adam-ctrlc/vital/README.md

# Vital

A Transformer Alert Management System for a 1 KVA distribution transformer, built as an electrical engineering thesis project at PHINMA Cagayan de Oro College, Carmen Campus.

An ESP32 measures the transformer and reports it to a Go API, which stores every sample, raises alerts when a reading crosses a threshold, and serves live readings to a web app that also ships as an Android app through Capacitor. The board also protects the transformer itself, opening a relay when the load runs away. The API can simulate the transformer from the clock, so the whole system can be demonstrated end to end with or without the hardware wired in.

## What it does

- Live monitoring of voltage, current, temperature and apparent power, with an animated AC waveform
- **Two-stage load protection**: an alarm at **900 VA** raises an alert, and a trip at **980 VA** opens the relay. Temperature alarms at **40 °C** but does not trip
- Alerts carry acknowledgement and response time, and the reading that triggered them, so a card shows how the transformer reached the threshold rather than only the value that crossed it
- Push notifications with a choice of **30 bundled tones**, a vibration pattern, and an alert length up to ten minutes. Everything is per device and can be switched off entirely
- Historical logs with server-side search, source and status filtering, and pagination, plus a daily load trend
- A data-source switch between a live ESP32 (the default) and the built-in simulation; hardware readings only show while the board is reporting, otherwise the dashboard reads "No data"
- Real device telemetry (IP, signal, uptime, firmware) reported by the board itself
- Configurable thresholds and full account management
- Two roles, decided by the account rather than a picker at sign-in

| Role | Who | Can reach |
|---|---|---|
| `admin` | Maintenance engineers | Everything: dashboard, alerts, logs, settings, users |
| `user` | Power utility personnel | Dashboard and alerts only |

## Architecture

```
ESP32  ──POST /readings + /device/heartbeat──>  Go API  ──>  Turso (libSQL)
   (x-device-key)                                  │
Web app   ──polls, bearer token───────────────────┘
(browser or Android, via Capacitor)
```

The API is stateless. Serverless functions cannot keep a background loop alive, so in simulation mode readings are a pure function of the clock, and a sample is persisted only when the newest stored row is older than `SAMPLE_INTERVAL_MS`. In hardware mode the ESP32 pushes readings and the API serves the latest one while it stays fresh.

## Tech stack

**API** Go, net/http, database/sql with libsql-client-go against Turso (SQLite over HTTP), JWT (HS256) auth, argon2id password hashing. Deployed to Vercel in the `hnd1` region, which is where the database is: every query is an HTTP request, so the two being in different countries cost about seventy milliseconds each way, every time.

**App** Vite, React 19, TypeScript, React Router, Tailwind, Phosphor icons and KaTeX, packaged for Android with Capacitor 8. It is a 1:1 port of the original Expo app, which has been retired.

**Firmware** ESP32 reading a PZEM-004T v3 energy meter and a DS18B20 contact temperature probe, tripping a relay, and driving a 20x4 I2C LCD. Header-only C++ with one class per component, ArduinoJson for every payload it builds or reads.

## Project structure

```
api/            Go API (see api/README.md)
  internal/     one package per domain: account, auth, readings, alerts, settings, device, users
  cmd/          server (local) and migrate
  schema.sql    the whole schema, applied by `go run ./cmd/migrate`
  migrations/   one-off changes to the existing database
  scripts/      pg-to-turso.mjs and other one-off data copies
  api/index.go  Vercel serverless entrypoint
appv2/          web app, and the Android app through Capacitor (see appv2/README.md)
  src/routes/   screens; tabs/ holds the tab group
  src/features/ API clients and types, split by domain
  src/components/
  android/      the Capacitor Android project
esp32/          firmware (see esp32/structure.txt and esp32/pins.txt)
  esp32.ino     mode selector: REAL_MODE, plus DS18B20 / LCD / PZEM / backend tests
  src/          config, hardware, net, core, tests (header-only classes)
```

## Getting started

### API

Create `api/.env`:

```
DATABASE_URL=libsql://your-database.turso.io   # https:// is accepted too
DATABASE_AUTH_TOKEN=the-token-turso-issues
JWT_SECRET=a-long-random-string
DEVICE_API_KEY=a-long-random-string
PORT=8080

# Read by the seeder only, never by the server.
SEED_ADMIN_PASSWORD=...
SEED_USER_PASSWORD=...
```

```bash
cd api
go run ./cmd/server
```

Apply the schema once with `go run ./cmd/migrate`. The server never does it: on serverless that would replay every statement on each cold start to discover there is nothing to do, and a schema change is a decision somebody makes rather than something that happens because a request arrived. Every statement is `if not exists`, so running it again is safe.

### Accounts

There are no accounts until you create one, and **the seeder is not committed**: this repository is public, and the accounts it creates are the live ones, since development and production share a database. Create `api/cmd/seed/main.go` (ignored by git):

```go
package main

import (
	"context"
	"log"
	"os"

	"github.com/google/uuid"

	"github.com/adam-ctrlc/vital/api/internal/auth"
	"github.com/adam-ctrlc/vital/api/internal/config"
	"github.com/adam-ctrlc/vital/api/internal/db"
)

func main() {
	if _, err := config.LoadDotenv(".env"); err != nil {
		log.Fatal(err)
	}
	cfg, err := config.Load()
	if err != nil {
		log.Fatal(err)
	}

	// From the environment, never a literal. The insert below reapplies the password
	// on every run, so a password written here would silently undo any rotation.
	plain := os.Getenv("SEED_ADMIN_PASSWORD")
	if plain == "" {
		log.Fatal("SEED_ADMIN_PASSWORD is not set")
	}
	hash, err := auth.HashPassword(plain)
	if err != nil {
		log.Fatal(err)
	}

	conn, err := db.Open(cfg.DatabaseURL, cfg.DatabaseToken)
	if err != nil {
		log.Fatal(err)
	}
	defer conn.Close()

	// The id is generated here because SQLite has no gen_random_uuid().
	_, err = conn.ExecContext(context.Background(),
		`insert into users (id, email, username, password_hash, role, first_name, last_name)
		 values (?, ?, ?, ?, ?, ?, ?)
		 on conflict (email) do update set password_hash = excluded.password_hash`,
		uuid.NewString(), "you@example.com", "you", hash, "admin", "Your", "Name")
	if err != nil {
		log.Fatal(err)
	}
}
```

```bash
go run ./cmd/seed
```

Further accounts can be created and edited from the app by an admin. Sign in with an email or a username.

### App

Create `appv2/.env`:

```
VITE_API_URL=http://localhost:8080/api/v1
```

```bash
cd appv2
pnpm install
pnpm dev
```

The site runs at http://localhost:5173. For the Android app, `pnpm apk` builds the site, syncs it into `android/` and assembles a debug APK; it needs JDK 21 and the Android SDK. The API URL is baked in at build time, and a phone cannot reach `localhost`, so build the APK against your machine's LAN address or a deployed API.

### Firmware

Copy `esp32/secrets.example.h` to `esp32/secrets.h` (gitignored) and fill in `WIFI_SSID`, `WIFI_PASSWORD`, `BACKEND_URL` and `DEVICE_KEY` (the key must match the API's `DEVICE_API_KEY`). Install the libraries listed in `esp32/structure.txt` (hd44780, OneWire, DallasTemperature, PZEM004Tv30, and **ArduinoJson 7 or newer**), pick a mode at the top of `esp32.ino`, and flash. `esp32/pins.txt` documents the wiring.

Flash `TEST_MODE = TEST_LCD` first. Its ruler screen fills all four rows to twenty columns, so a blank row or column means the configured geometry does not match the panel.

## API

Everything is under `/api/v1`. All routes except `/health` and `/auth/login` need a bearer token, except the ingest and device endpoints, which authenticate with the `x-device-key` header.

| Route | Method | Access | Notes |
|---|---|---|---|
| `/health` | GET | public | Check time, UTC and local |
| `/auth/login` | POST | public | Email or username; returns a token and the account. Rate limited per caller |
| `/auth/me` | GET / PUT | any | Read or update the current account |
| `/auth/password` | PUT | any | Change own password |
| `/readings/latest` | GET | any | Live reading plus thresholds and link state |
| `/readings` | GET | admin | Paginated history; `q`, `status`, `source`, `limit`, `offset` |
| `/readings` | POST | device key | Hardware ingest; any subset of the fields |
| `/readings/trend` | GET | admin | Daily averages; `days` |
| `/alerts` | GET | any | Paginated; `q`, `kind`, `active`, `limit`, `offset` |
| `/alerts/{id}/ack` | POST | any | Acknowledge, recording response time |
| `/settings` | GET / PUT | any / admin | Alarm, trip and temperature thresholds |
| `/settings/source` | PUT | admin | Switch simulation or hardware |
| `/device/status` | GET | **admin** | Live link state and telemetry |
| `/device/heartbeat` | POST | device key | Board reports its IP, signal, uptime, firmware |
| `/notifications/register` | POST | any | Store this device's push token and chosen channel |
| `/notifications/unregister` | POST | any | Drop it, so a signed-out device stops being notified |
| `/users` | GET / POST | admin | List and create |
| `/users/{id}` | PUT / DELETE | admin | Edit or remove |

List endpoints return `{ rows, total, limit, offset }`. `total` counts every row matching the filters, not just the returned window.

### Readings

An ingest may carry any subset of the fields, so a board with only a temperature probe still reports:

```json
{ "temperatureC": 31.5 }
```

A fully wired board reports:

```json
{
  "voltageV": 230.1, "currentA": 3.2, "temperatureC": 31.5,
  "powerW": 690.2, "powerFactor": 0.94, "frequencyHz": 60.01, "energyKwh": 12.5
}
```

A reading with nothing in it at all is rejected with a 400 rather than stored: a row of nothing but nulls is indistinguishable from a gap in the record, and it would count towards the sample interval while carrying no measurement.

Missing measurements are stored as null and shown as "No data" in the app. Apparent power is derived as `S = V * I` when both are present. Reactive power is derived from the power triangle, `Q = sqrt(S^2 - P^2)`, only when real power was measured.

### Protection

Two load levels, and they do different things.

| Level | Default | Effect |
|---|---|---|
| Alarm | 900 VA | Raises an alert, marks the reading as an overload. Nothing is switched |
| Trip | 980 VA | Opens the relay after the load holds above it for 3 s |

The relay closes again once the load is back at or under the **alarm** level and at least the reclose delay has passed since the trip. Reclosing at the alarm rather than a fixed percentage below the trip makes the deadband the operator's own two numbers, and the trip-above-alarm rule that the API, the app and the firmware each enforce is what guarantees it is never zero.

### Reclosing, and why it gives up

Opening the relay removes the current the board judges by. Zero amps then means "nothing is flowing", not "the fault is gone", and the board cannot tell the two apart. The only way to find out is to close and look.

So it does, a bounded number of times. Three attempts at the **reclose delay** apart (default 30 s, an operator setting between 5 and 600 s), and if the overload is still there each time it stops trying and holds the relay open until an admin closes it. The delay is uniform rather than escalating on purpose: backing off would stretch the run over minutes, and every attempt is another inrush into a fault nobody has fixed.

A lockout is stored separately from the trip in NVS, because a trip is a state the board can leave on its own and a lockout is one it cannot. Losing it to a brownout would re-energise the exact fault it was holding open.

**An admin can open or close the relay from the app.** Neither defeats the protection: an overload re-opens the contacts three seconds later whoever closed them, and a close that the protection undoes is refused for another three seconds so the two cannot fight several times a second. The command is a request rather than a call, because nothing can reach the board: it sits behind whatever NAT and only speaks outward, so the command waits for its next heartbeat. While locked out the board heartbeats every five seconds instead of thirty, so a reset lands in seconds.

**Current flowing through contacts reported open** is treated as the contacts being wrong rather than the meter: a measurement is evidence and a state is a belief. The board re-drives the output, which recovers a write that never landed, and the app shows a warning if it persists, which is usually a welded contact and the failure that makes a protection scheme decorative.

Two deliberate choices worth knowing:

- **This runs on the board**, not in the API, so the transformer stays protected with the Wi-Fi down or the app closed. A trip is written to NVS and survives a reboot, because a fault is exactly the condition that browns out the supply.
- **A missing measurement holds the trip.** If the meter stops answering while tripped, the board will not reclose: it cannot confirm the fault is gone. Temperature alarms but never trips, since 40 °C is an advisory level for a transformer rather than a damage limit, and tripping on ambient warmth would be a nuisance.

## Notifications

Each device chooses a tone, a vibration pattern and how long an alert buzzes for. All three are stored on the phone; only the tone reaches the server, and only because of how Android works.

**Android takes a notification's sound from its channel, and freezes a channel's settings when it is created.** A channel's sound can never be changed afterwards, so choosing a tone means choosing a *different channel*, and the app registers one per tone at startup. They appear individually in the phone's own notification settings, which is also where someone can override the app's choice. Once they do, the app cannot override it back.

That has a consequence worth stating plainly, because the two look identical until the app is closed:

| | With the app open | With the app closed |
|---|---|---|
| Bundled tone | The app plays the file | Android plays it, from the channel |
| Vibration pattern | The app drives the vibrator | Fixed by the channel, not the picker |
| An uploaded file | The app plays it | Not possible: Android will not take a file the user picked |

Because a remote push is composed on the server, the chosen channel travels with the push token and is re-registered whenever the tone changes. A push naming no channel lands on the default one, which is the old behavior and what an iOS device or an older client still gets.

**Remote push is currently off.** The API sends through Expo's push service, which only accepts tokens from an Expo app; the Capacitor app gets Firebase (FCM) tokens instead. Until the API sends through FCM, alerts notify while the app is open or in the background, but not once it has been closed.

The tones are generated, not shipped as recordings: `appv2/scripts/build-alert-sounds.mjs` synthesizes all thirty as WAV files from sine, square, noise and struck-bell primitives. They sit between roughly 1 and 3 kHz, which is where a phone speaker is loudest and where a tone still carries across a room with a transformer humming in it. Regenerating is deterministic, so the files do not churn in every commit.

Each one runs for **12 seconds**, the motif repeating with a breath between passes rather than being stretched. That length is not cosmetic: with the app closed, Android plays the channel's sound exactly once and will not loop it, so whatever is in the file is the entire alarm. A quarter of a second reads as a ping; this reads as something wanting attention. They are written at 22.05 kHz because the highest partial any of them carries is under 5 kHz, which halves thirty files that are now twelve seconds each.

Where the app can schedule notifications itself, it posts a fresh one as each tone finishes, for as many passes as the chosen length needs. A remote push cannot do this: it is composed on the server, and a serverless function cannot hold a timer to send follow-ups, so a real alert arriving at a closed app is one twelve second tone.

**Tapping a notification stops the alarm.** Everything still queued is cancelled, the buzz stops, the tray is cleared, and the alert is acknowledged. Acknowledging from the notification rather than only from the Alerts screen means the response time measures reaching for the phone, not navigating the app afterwards.

**Profile has a Test button** that schedules real notifications a few seconds out, covering the chosen alert length, and turns into a Stop while they are queued: covering ten minutes schedules fifty of them, and without a way to call them off the only way to end a test would be to sit through it. Preview cannot demonstrate the closed case: it plays the file in process, so it stops when the app goes to the background, while the vibration, a system call, carries on. That looks like sound being broken when it is really two unrelated paths.

## Notes

- The data source is a runtime setting, not an environment variable, and it defaults to **hardware**. In hardware mode the API serves the newest hardware reading only while it is within a 30 second window; after that the dashboard reads "No data". A dashboard stuck on "No data" usually means the board has stopped reporting, not that the app is failing to refresh.
- `SAMPLE_INTERVAL_MS` throttles writes, not the dashboard: the live view polls every second regardless. It defaults to 15s because a transformer's thermal behavior moves over minutes.
- There is no connection pool and nothing to size, which is the point. The Postgres build lost two afternoons to connection budget: a session pooler allows fifteen clients, a warm serverless instance holds its connections long after it stops serving, and once a handful of idle instances held the lot, every cold start failed to build and returned 500 on every route including ones that never touch the database. Over HTTP an idle instance costs nothing.
- Timestamps are text in RFC 3339, always UTC, always with the Z, because SQLite has no date type and string comparison is what makes `order by recorded_at desc` mean "newest". Mixing precisions breaks that: `.828597+00:00` sorts before `.900Z` of the same second. `strftime('%Y-%m-%dT%H:%M:%fZ', ...)` is the one format everything is written and imported in.
- Uuids are text and booleans are integers, for the same reason: SQLite has neither type.
- After changing an environment variable on Vercel, deploy with `--force`. A cached build keeps the old environment.
- Hardware ingest requires the `x-device-key` header to match the API's `DEVICE_API_KEY`; with no key set, ingest is rejected.
- The grid here runs at **60 Hz**; the nominal supply is 230 V.
- Times are stamped in UTC and rendered at UTC+8.

## Scripts

From `appv2/`:

- `pnpm dev` starts the development server
- `pnpm build` builds the static site into `dist/`
- `pnpm apk` builds a debug APK; `pnpm android` opens the project in Android Studio
- `node scripts/build-alert-sounds.mjs` regenerates the thirty alert tones

From `api/`:

- `go run ./cmd/server` starts the API
- `go run ./cmd/migrate` applies `schema.sql`, and reads the result back rather than trusting its own count; `-file migrations/<name>.sql` applies one migration
- `go run ./cmd/seed` creates accounts, if you have added a seeder
- `go test ./...` runs the tests; `go test -tags sqlite ./...` adds the end-to-end ones against a local SQLite file

## License

Apache License 2.0. See [LICENSE](LICENSE).
</content>
