adam-ctrlc/vital/esp32/secrets.example.h

#pragma once

// Copy to secrets.h (gitignored) and fill in.
#define WIFI_SSID "your-wifi-name"
#define WIFI_PASSWORD "your-wifi-password"
#define BACKEND_URL "https://dynavolt-api.vercel.app"
#define DEVICE_KEY "same-as-DEVICE_API_KEY-on-the-api"
