adam-ctrlc/vital/(commit log)

2026-07-25 Harden the API, app and firmware, and gate the app on connectivity
    Security and crash fixes across all three codebases, plus a startup
    connectivity check in the app.
    API:
    - Treat a blank DEVICE_API_KEY as unset. env::var returns Ok("") for a
    variable that is set but empty, which then matched the empty
    x-device-key header any caller can send and left ingest open.
    - Make TrendPoint's aggregates nullable. Migration 0011 made the columns
    nullable, so a day of temperature only readings made avg() return NULL
    and turned the trend endpoint into a 500.
    - Rate limit and log failed logins. There was no throttle and no record,
    so a guessing run left no trace anywhere.
    - Validate the range of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
    [pnpm-lock.yaml]
2026-07-26 Repair migration 0012 and build the ESP32 JSON with ArduinoJson
    Migration 0012 had reached the shared database out of band: its DDL took
    effect but the _sqlx_migrations row was never written, so sqlx kept
    re-running it against a schema where device_config had already been
    dropped. Every statement in it tolerated a re-run except the seed, which
    reads that table, so the dev server aborted on 42P01 before it could
    serve or apply 0013 and 0014. Guarding the read makes the migration
    idempotent; a fresh database still seeds normally because 0003 creates
    device_config. Applying it recorded 12, 13 and 14 and changed no data,
    since all three were already reflected in the schema.
    The firmware now bui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
2026-07-26 Log heap health on the ESP32 diagnostic line
    Adds free, largest-allocatable and low-water-mark heap to the 1 Hz serial
    JSON. Nothing measured the heap before, so the one question this firmware
    could not answer was whether it lasts a month on a transformer or only an
    afternoon on a bench.
    The three are read together because the failure modes differ. Free heap
    sliding down on its own is a leak. Free heap holding steady while the
    largest allocatable block sinks is fragmentation, which is the likelier
    one here: every backend call builds and tears down a TLS context of tens
    of KB, and this board has no PSRAM, so that comes out of the same ~320 KB
    pool as everything else. Once the largest block f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
2026-07-26 Make alerting and simulator sampling safe under concurrent viewers
    The dashboard polls once a second from every open app, and in simulation
    mode that poll can write. Both write paths guarded themselves by reading
    first and inserting second, which holds for one viewer and fails for
    several: each request reads the state before any of them commits, so they
    all decide to write.
    Sampling produced a row per viewer per interval rather than one, which
    skewed every average and maximum the trend endpoint reports toward
    whichever times had the most people watching. Alerting was worse: each
    duplicate opened its own alert and pushed a notification to every
    registered device, so one overload arrived as a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
2026-08-01 Document the relay in pins.txt
    Pins.h has declared RELAY_PIN, RELAY_ON and RELAY_OFF all along, but the
    wiring plan stopped after the PZEM, the probe and the LCD, and P5 was
    listed among the usable pins with nothing marking it as taken. Anyone
    wiring the board from this file would have had a spare terminal and an
    undocumented relay.
    Records what the code already does: active low, IN on P5, and the load on
    COM and NO. Also the reason P5 was the right choice, which is not obvious
    and is worth being able to explain. It is a strapping pin with an internal
    pull up, so it reads HIGH from reset until setup() runs, and HIGH is
    RELAY_OFF. The load therefore stays de-energized for the whole boot wind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
2026-08-01 Correct the PZEM supply in pins.txt to 3.3V
    The wiring plan had the meter on 5V with a note to add a level shifter or
    divider between its TX and P16, because a 5V powered module idles its TX at
    5V into a pin that is not 5V tolerant. The board is actually built with the
    PZEM logic side on 3V3, which is the better arrangement and the reason no
    shifter is fitted: the module idles TX at whatever rail it is given, so on
    3.3V it sits inside the ESP32's input range already.
    Anyone rebuilding from the old text would have wired 5V and then either
    added a part that is not on the board or fed 5V into P16.
    Also records that the isolated logic rail is the only side this section
    covers, and that a meter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
2026-08-01 Drive the LCD as the 20x4 it actually is
    Pins.h declared 16 columns and 2 rows, so the panel was being driven as a
    16x2 and everything below the second row, and right of the sixteenth
    column, sat unused. Half the display was dark.
    Lcd::show takes two more lines, both defaulting to empty, so the eight
    existing two-line call sites are untouched and the rows they leave out are
    blanked rather than left holding the previous screen. The row loop now runs
    to the configured height instead of writing row 0 and row 1 by hand.
    The status screen fills all four rows: title with the status flush to the
    right edge, then the measured pair, then apparent power and temperature
    each next to the threshold it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
2026-08-01 Split the alarm from the trip and wire the relay to it
    One number did both jobs: load_threshold_va raised the alert and decided
    the board's overload state. Connecting the relay to that would have cut the
    load in the same instant the warning appeared, leaving nobody a window to
    shed it themselves. Protection wants two levels, so there are now two.
    Alarm stays at 900 and only raises an alert. Trip defaults to 980 and is
    what opens the relay, after the load has held above it for three seconds so
    a momentary inrush cannot cut the supply. It closes again once the load is
    back at or under the alarm, and never sooner than thirty seconds after the
    trip. Reclosing at the alarm rather than a percenta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
2026-08-01 Let this device turn alert notifications off
    Profile had no control over notifications at all: the app asked for the
    permission at sign-in and then notified regardless.
    The switch is a stored intent rather than a reading of the OS permission,
    because the two answer different questions and an app cannot revoke its own
    permission. Without somewhere to record what the user wants, switching off
    would have done nothing. The flag gates all three things that interrupt:
    the push registration, the vibration, and the local banner.
    Turning it on asks the OS first, so the switch never claims something the
    permission will not allow. Once Android has refused, the prompt cannot be
    raised again, so rather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
2026-08-03 Default the data source to the ESP32, and measure the sheet's keyboard lift
    The simulation exists so the system can be shown before the board is wired
    in. That is the exception now, not the starting point, so a fresh install
    comes up expecting hardware and reads "No data" until the board reports,
    rather than showing convincing numbers nobody measured.
    Both halves of 0018 are needed. Changing the column default alone would not
    reach a fresh database: 0001 inserts the settings row before 0010 adds the
    column, so 0010 backfills that row to 'simulation' and the new default never
    applies to it. Production was already on hardware, so the update line
    changes nothing there.
    The bottom sheet now me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
2026-08-03 Bring the README up to date with the protection scheme
    It still described a 16x2 display, a single load threshold, /device/status
    as readable by any account, and the simulation as the starting point. All
    four had moved.
    The seeder template mattered most. It showed the password as a literal,
    which is the pattern that put one in a committed-adjacent file to begin
    with, and the warning above it explained the symptom rather than the cause.
    It now reads the environment and says why: the insert reapplies the
    password on every run, so a literal there silently undoes any rotation.
    Adds a Protection section, which nothing documented even though the relay
    now actually opens. Covers both levels, the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
2026-08-09 Add bundled alert tones and release idle database connections
    The pooler runs in session mode with a 15 client limit, and each serverless
    instance held five connections for as long as it stayed warm. Three warm
    instances took the whole budget, after which every cold start failed to build
    and returned 500 on every route, including ones that never touch the database.
    Connections are now capped at two per instance and released once idle.
    Alerts carry the reading that triggered them, joined server side, so a card can
    show how the transformer reached the threshold rather than only the value that
    crossed it. Left joined: an alert outlives its reading.
    Ship thirty notification tones, synthesised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
    [pnpm-lock.yaml]
2026-08-09 Fit the pager to the screen and guard the page input
    The number cells are a fixed width and React Native does not shrink flex
    children by default, so a row that does not fit runs off the screen rather
    than compressing. Five numbers need a 348px screen; a 320px phone overflowed
    by 28. The row now derives how many numbers it can show from the width
    actually available, down to a floor of three, which is the fewest that can
    still show the first page, the last page and the one you are on.
    The jump field refused nothing and relied on the clamp in goTo, so typing 999
    landed on page 20 with nothing to say why. It now rejects a keystroke that
    would take it past the last page and says how many there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
2026-08-09 Deliver alert pushes on the channel the device chose
    A tone played while the app was open and went silent the moment it was closed.
    The two paths are unrelated: with the app open the app plays the file itself,
    and with it closed Android reads the sound off the notification channel the
    push is delivered on. The push named no channel, so every one landed on the
    default and the thirty tone channels sat unused. Vibration still fired, which
    is what made it look like sound alone was broken.
    The tone is a per device choice but the push is composed on the server, so the
    channel now travels with the push token. It is nullable and omitted from the
    message when unset, leaving older registrations and i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
2026-08-10 Add a way to hear an alert with the app closed
    Preview plays the file in process, so it stops the moment the app goes to the
    background while the vibration, a system call, carries on. That looks like the
    sound being broken when it is really two different paths: a real alert is drawn
    by Android from the notification channel and does not involve the app at all.
    Preview cannot demonstrate that path, which left no way to check the thing that
    matters most.
    The test button schedules a real notification a few seconds out on the chosen
    channel. The delay is the point: schedule it, close the app, listen.
    Background playback would have been the smaller change and the wrong one. It
    would still be the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
2026-08-10 Make an alert last, and let tapping it stop
    With the app closed Android plays a channel's sound once and will not loop it,
    so whatever is in the file is the whole alarm. A quarter of a second reads as a
    ping. Each tone now runs for twelve seconds, the motif repeating with a breath
    between passes rather than stretched, written at 22.05 kHz because nothing in
    them reaches 5 kHz and thirty files are now twelve seconds each.
    Where the app schedules notifications itself it posts again as each tone ends,
    for as many passes as the chosen length needs, uncapped: the length is the
    setting and a ceiling would quietly ignore it. Covering ten minutes means fifty
    notifications, so the test button become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
2026-08-10 Let the alert sound follow the app into the background
    The vibration is a system call and carried on when the app was put down; the
    sound stopped, because expo-audio does not play in the background unless asked.
    An alert therefore half survived being backgrounded, which is the ordinary case:
    switching apps, screen off, phone in a pocket. Both halves now run the chosen
    length there.
    This covers backgrounded, not killed. With no process there is no player, and
    the twelve second tones and their repeats are what carry the alarm instead.
2026-08-13 Raise the alarm without waiting for the next post
    The board only spoke every ten seconds, so crossing the alarm level waited up
    to that long before the backend heard about it, and every one of those seconds
    came off the front of the notification. A crossing is now posted in the same
    pass that sees it, with no timer between.
    The ten second cadence is left alone rather than reset by that post, so stored
    rows stay evenly spaced whether or not an alarm interrupted them. The crossing
    writes one extra row on purpose: the alert links to a reading, and that reading
    is the one that caused it.
    Acknowledging in the app stops the alarm too. Tapping the notification was the
    only way to end one, which i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
2026-08-13 Read the board directly when the app can reach it
    A measurement reached the app seconds after it was taken: a TLS post, a row
    written, then a poll on the other side. When the phone and the board share a
    network, and a phone hotspot is one, the app can ask the board itself and have
    it immediately.
    The board now serves its snapshot over plain HTTP. A device on a local address
    cannot hold a certificate anyone would trust, and a self-signed one only teaches
    people to click through warnings, so the app declares cleartext instead. What it
    exposes is what the app already shows, to callers already inside the network.
    The backend stays authoritative for everything that is not a measurement: the
    thr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
2026-08-13 Keep announcing an overload that has not gone away
    An alert is raised once per condition so the list does not fill with duplicates
    of one ongoing fault, and the notification was tied to that same rule: one push,
    ever. A transformer sitting above its threshold therefore announced itself once
    and then went quiet, which is the opposite of what an alarm is for. It looked
    like alerts were not firing at all, when they were firing exactly once.
    An unacknowledged condition is now re-announced every minute against the same
    alert, so the history stays one row per condition while the phone keeps being
    told. The claim is a single update rather than a read and a write, because the
    board and every open d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
2026-08-14 Move the database into a spreadsheet
    Every table is now a tab in a Google Sheet, reached over the Sheets REST API.
    The HTTP surface is unchanged, so neither the app nor the firmware needed a
    line altered for this.
    Three things make it workable at all. Reads are cached, because Google allows
    sixty calls a minute per caller and the dashboard polls once a second: without
    that one open app would sit exactly on the ceiling and a second would exceed it.
    The newest reading is found by reading the end of a tab rather than sorting it,
    since sorting means pulling a quarter of a million rows to answer a question
    asked every second. And readings roll over monthly, because ten million cells is
    about for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
2026-08-14 Move the board off Postgres and give the relay its other half
    The API now talks to Turso over HTTP instead of Postgres through a session
    pooler. There is no pool to size and no connection budget to exhaust, which
    is what took production down twice: a warm serverless instance held its
    connections long after it stopped serving, and once a few idle instances
    held all fifteen, every cold start failed to build and returned 500 on every
    route including ones that never touch the database.
    Timestamps are text in RFC 3339 with the Z, always. SQLite has no date type,
    so string comparison is what makes "order by recorded_at desc" mean newest,
    and mixing precisions breaks it.
    The relay's manual contro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
    [Lcd.h, LiveServer.cpp, LiveServer.h, Relay.h]
2026-08-14 Let a reported lockout enable the relay buttons on its own
    The position and the lockout reach the app by different routes: the position
    comes from the newest hardware reading, the lockout from the heartbeat. A
    board whose meter has stopped answering posts no readings at all, because
    postReading bails when every measurement is NAN, so the position freezes at
    whatever it last was and may well be "closed". The heartbeat keeps reporting
    the lockout truthfully throughout.
    Gated on position alone, that board showed "Locked out" with both buttons
    greyed out: the one screen that can release it, refusing to.
2026-08-14 Gate the relay buttons on the board reporting, and nothing else
    Every version of this that reasoned about state got somebody stuck, because
    the facts it reasoned from arrive by different routes and disagree exactly
    when things are going wrong. The position comes from the newest hardware
    reading and the lockout from the heartbeat, and a board whose meter has
    stopped answering posts no readings at all, so the position freezes while
    the heartbeat keeps reporting the truth.
    Nothing was gained by being clever. The protection does not live in the app:
    an overload opens the contacts on the board regardless of what this screen
    offers, so a button enabled at an unhelpful moment costs a wasted tap, w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
2026-08-14 Let the relay position expire with the link
    /device/status took the position from the newest hardware reading whatever
    its age, and only `connected` checked the freshness window. One row from
    hours ago therefore reported a confident CLOSED forever, claiming the supply
    was reaching the load on the strength of a reading nobody had refreshed
    since. The board may have tripped, been switched off or been unplugged in
    between, and none of that reaches us.
    Unknown is the honest answer and the app already renders it as its own
    state, distinct from open and closed, for exactly this reason.
    last_seen is deliberately left alone: "the board was last here at 06:04"
    stays true however old it gets, while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
2026-08-14 Move the app to the kaizen252526 EAS project
    The previous account had spent its monthly Android builds on the free plan.
    Unbinding meant clearing both halves of the link, owner and the projectId
    under extra.eas, since eas init will not relink a project that still names
    another account as its owner.
    The android package is deliberately left as com.peregrineadrift.vital. It is
    the app's identity on the device rather than anything to do with the build
    account, and changing it would orphan every installed copy for no gain.
    Builds from this account carry a new keystore, so the resulting APK will not
    install over one from the old account.
2026-08-14 Remember the reclose delay across a reboot, like the thresholds
    The three thresholds were persisted to NVS and the reclose wait was not, so
    every reboot silently reverted it to the compiled thirty seconds until the
    next heartbeat corrected it, and a board that could not reach the backend
    held a fault open for thirty seconds no matter what the operator had set.
    Written only after the monitor accepts the value, so one refused for being
    out of range does not become the value that survives the next reboot, and
    only when it differs from what is already stored, so an unchanged heartbeat
    every thirty seconds does not wear the flash.
    Kept out of applyThresholds because the two are independent sett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
2026-08-14 Let an operator set the trip delay, up to a minute
    The wait that decides whether to cut the load was a firmware constant at
    three seconds, while the wait that decides when to try again was already an
    operator setting. How long a transformer should be allowed to sit over its
    trip level is a property of the transformer and the load, not something to
    reflash, and the two waits belong on the same screen.
    Optional on the wire. A build already in somebody's hand sends the four
    fields it knew about, and the server coalesces the absent one to what is
    stored. Required, that build's settings screen would start failing;
    defaulted, it would quietly undo this value every time anyone saved a
    threshold fr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
2026-08-16 Run the API in Tokyo, where the database already is
    Vercel was in sin1 and Turso is in aws-ap-northeast-1, so every query left
    the country and came back. Over HTTP that is paid per request rather than
    per connection, and /device/status makes three, so the round trips stacked.
    Measured before and after on the same routes:
    /health 189 -> 262 ms (+73, no database)
    /settings 471 -> 273 ms
    /readings/latest 627 -> 283 ms
    /device/status 873 -> 300 ms
    The health route got slower, which is the honest cost: Tokyo is further
    from the phone than Singapore is. Everything that touches the database got
    much faster, and the further a route was from the database the more it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
2026-08-19 Finish the result set before the next query, and carry the relay command on readings
    Two things, found chasing why the relay behaved in a bench sketch and not in
    the firmware.
    An abandoned result set poisons the connection. Over HTTP a result set is a
    statement still open on the stream, and taking one row from a `returning`
    without draining the rest leaves the stream in a state the server refuses
    further requests on. The next query fails with "stream not found: <id>",
    which reads like the database went away rather than like the previous
    statement was never finished.
    Every other `returning` in this codebase is the last statement of its
    request, so nothing followed it to trip over. Ingest is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
    [Relay.h]
2026-08-19 Keep the flash writes away from the moment the contacts move
    An NVS write is an erase cycle: tens of milliseconds of raised current, and it
    blocks. It was happening in the same loop pass that switched the relay,
    microseconds after the coil inrush, and an operator pressing off triggers two
    of them because the trip and the lockout are stored separately.
    Three current spikes on one rail inside a few milliseconds is what made the
    module's LED dim and the contacts hesitate on a board that switches cleanly
    under the standalone bench sketch, which has no NVS at all. That difference
    is what pointed here: the supply is marginal, but the firmware was choosing
    the worst possible moment to lean on it.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
2026-08-19 Drive the relay input through a transistor
    A 3.3V pin cannot switch this module off. IN is pulled up to 5V inside the
    module, so driving it to 3.3V leaves 1.7V across the opto LED: it keeps
    conducting, the input LED glows dim instead of going dark, and near the
    threshold it chatters. Pulling low always worked. It was the off state that
    could not be reached, and no passive part fixes that, because none of them
    can raise 3.3V to 5V.
    An NPN with its base behind 4.7k solves it by never sourcing the 5V at all.
    It gets out of the way and lets the module's own pull-up reach the full rail.
    4.7k gives about 0.55 mA of base current, a forced gain near nine for a 5 mA
    input: saturated with room to spa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
2026-08-19 Hold the relay buttons until the contacts have actually moved
    They re-enabled as soon as the request returned, which only proves the
    backend wrote the command down. The board acts on its next post, so for a
    few seconds after that the buttons invited a second press against a relay
    that was still moving.
    The wait now watches the reported position rather than the request, and ends
    when the board reports the position that was asked for. While it is running
    the card polls once a second instead of once every five, because the answer
    arrives within a posting interval and there is no reason to spend four of
    those seconds looking at a disabled button for a relay that has already
    moved.
    It gives up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
2026-08-19 Pull the relay wait decision out where it can be tested
    The condition that decides whether to keep the buttons held has more edges
    than its three lines suggest, and none of them were exercised: an unknown
    position must not be mistaken for the one that was asked for, since unknown
    is exactly what a disconnected board reports and releasing on it would open
    the controls for a relay nobody can see. A command that lands in the same
    instant the wait expires has to read as having worked rather than failed,
    which is why the match is checked before the deadline.
    Fifteen cases over it now, including both of those. The card calls the same
    function, so the tests cover the code that runs rather than a c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
2026-08-19 Report a commanded relay change at once instead of on the next interval
    The command reaches the board on the response to a post, and that post was
    sent before the contacts moved, so it still described the old position. The
    app therefore did not learn the relay had switched until the following post,
    which doubled the wait it shows an operator: up to ten seconds of disabled
    buttons for a relay that moved in under one.
    The board now backdates its post timer when a command actually changes the
    position, so the next pass reports it. Backdating rather than posting from
    there keeps the request on the one path in loop() that owns it, and the
    underflow in the first five seconds after boot is harmles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
2026-08-19 Leave the firmware alone and wait longer in the app instead
    Reverts the post backdating. It halved the wait an operator sits through, but
    the board it changes is already flashed and behaving, and a firmware change
    made in service of an app affordance is not worth another flash.
    The wait is therefore back to the longer path, and the thirty second window
    is sized for it: the command reaches the board on the response to a post that
    was sent before the contacts moved, so the new position only arrives on the
    following post. Up to ten seconds, plus two round trips, plus another five if
    one is lost. The comment said the board reported immediately, which stopped
    being true the moment this was rever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
2026-08-27 Cut the firmware comments down to what they need to say
    The ESP32 side had grown comments that explained the same point three ways,
    narrated edits that git history already records, and restated one-line getters.
    Kept the reasoning a reader cannot recover from the code: why the relay needs a
    transistor, why the PZEM cache fabricates zeros, why a trip has to survive a
    reboot, why applyRelay re-drives the pin every pass. Dropped the retelling.
    Comment lines across the firmware go from 594 to 373. No code changed: the
    compiled image is byte-identical to the previous commit apart from the ELF hash
    and the image checksum that follows from it.
    [Lcd.h, LiveServer.cpp, LiveServer.h, Relay.h]
2026-10-09 Get the board back online in seconds when the Wi-Fi drops
    A TLS handshake on a link that was up but losing packets could hold the loop for up to
    two minutes, during which nothing posted, nothing reconnected and the dashboard read the
    board as offline. Requests now have bounded connect, handshake and response timeouts, and
    a failed one drops the kept-alive socket so the next starts clean.
    When three posts in a row get no HTTP answer at all, the link is rejoined, because the
    driver can keep reporting connected long after traffic stopped. After about a minute of
    failed joins the radio is restarted. Modem sleep is off, which costs average current but
    not the transmit peak the brownouts came fro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
2026-10-09 Filter logs by date, load and temperature, and sort them
    The history endpoint takes from/to instants, minimum and maximum apparent power, a
    minimum temperature and a sort of newest, oldest, highest load or highest temperature.
    Bounds are validated, instants are rewritten into the stored timestamp shape so they
    compare as text, and the sort comes from a fixed list rather than the request.
2026-10-09 Replace the Expo app with a web app packaged by Capacitor
    appv2 is the same app as an ordinary website: Vite, React, Tailwind and React Router,
    deployed to Vercel and wrapped for Android with Capacitor. The screens were redesigned
    along the way (settings and profile as grouped rows, alerts and a logs table with
    filters, a waveform that follows the load, a full colour palette, registration).
    Updates are required and arrive inside the app: releases are published to
    adam-ctrlc/vital-releases, the app downloads only the files that changed, and a version
    that fails to start is rolled back. The Expo app is removed.
    [pnpm-lock.yaml]
2026-10-09 Spread the logs toggle and filters across a phone's width
    Once the filter row wraps, Overloads only sits at the left edge and Filters at the right,
    instead of the two bunching up together.
2026-10-09 Redesign the slider with a filled track, a round thumb and step marks
2026-10-09 Scroll the date and sort chips sideways in the filters sheet on phones
2026-10-09 Add migration 0024: per-reading limits, relay command ids and the board's reset reason
2026-10-09 Keep each reading's limits, redeliver relay commands until the board acknowledges them, and store why the board restarted
2026-10-09 Show why the board last restarted in the device section
2026-10-09 Run the ESP32 protection on its own task and stop the firmware fighting the Wi-Fi driver
    - Protection (sampling, trip timer, relay) runs on a FreeRTOS task with a watchdog, so a slow HTTPS call can no longer delay or block a trip
    - Wi-Fi never blocks and no longer disconnects itself when the API is slow; the driver's own reconnect is left to work
    - Relay commands are acknowledged by id, so one lost reply no longer loses the command
    - After a brownout reset the relay waits before closing, breaking the click-reboot loop
    - Reports the reset reason; the live server is asynchronous
    - Protection logic is pure C++ with host tests; bring-up sketches moved to tests/
    [Backend.cpp, Backend.h, Boot.cpp, Boot.h, Config.h, Controller.cpp, Controller.h, Lcd.h]
2026-10-09 Add migration 0025: energy rate, nominal voltage and the audit log table
2026-10-09 Add insights, the readings CSV export and an audit log of operator changes
    - GET /insights: energy and cost per Manila day, a weekday-by-hour load heatmap, voltage sags and swells, loaded power factor with a capacitor sizing, IEEE C57.91 insulation aging, and alert response times
    - GET /readings/export streams the readings of a date range as CSV
    - GET /audit lists settings, relay and account changes with who made them
    - Settings gain the energy rate and nominal voltage
2026-10-09 Add Energy, Peak hours, Power quality, Transformer aging, Reports and Audit log for admins
2026-10-09 Page the worst voltage events and the energy days with the shared pager
2026-10-09 Keep a panel's Edit button on the same line as its text
2026-10-09 Describe the current trips in the help and the trip delay sheet
2026-10-09 Hand relay commands over without a transaction, which Turso's HTTP streams were closing
    Every handover and heartbeat failed in production with 'stream is closed', so relay commands
    from the app never reached the board. Each step is now one pooled statement, the clear is
    guarded by the command id, and idle connections are dropped before Turso closes them.
2026-10-09 Ignore anything at the board's address that is not a board reading
2026-10-09 Draw the temperature as a third wave: green to yellow to red, taller and thicker as it heats
2026-10-09 Show active alerts as compact rows with the Acknowledge button beside them
2026-10-13 Let people choose a profile picture, compressed on the device and shown wherever initials were
